bridgewire/hodor_picontroller/docs/hardware_discrete/schematic_notes.md

# Schematic notes

T1 (power supply) Screw terminal connectors Left to Right:

| L | N | GND | V2 | COM | V1 |
| --- | --- | --- | --- | --- | --- |
|  |  |  |  |  |  |  |

Signal Descriptions:

| Name | Description |
| --- | --- |
| L | Mains input live (black or red) |
| N | Mains input neutral (white) |
| GND | Mains input frame ground (green) |
| V2 | 12V supply output |
| COM | supply output common ground |
| V1 | 5V supply output |

MCU1 (Raspberry Pi) GPIO pin usage:

| Pin Number | Description |
| --- | --- |
|  2  | +5V (suggest use along with 4) |
|  4  | +5V (suggest use along with 2) |
|  6  | GND |
| 8-14 | (unused) |
| 16 | GPIO16 - assert high when authorized user scans card |

**NOTE** Pins 2,4 required for direct wire connection to power supply T1.  Pins 2,4 may be left unused if one supplies power to the Raspberry Pi via the micro-USB port.

MCU2 (Arduino) connection points:

| Pin ID | Description |
| --- | --- |
| VIN | Power supply in (regulated 5V) |
| GND | Ground |
| D13 | integrated LED |
| D5  | unlock pin (assert high) |
| D4  | accept pin (assert high) from RPi |
| D3  | door switch input |
| D2  | door LED enable (assert high) |
**NOTE** : The VIN pin required for connection to power supply T1.  The VIN pin may be unused if Arduino is powered by USB or barrel connector

RLY1 (Beefcake Relay Control Kit) connection points:

Low-voltage (smaller, black) terminal block:

| Pin Name | Description |
| --- | --- |
| 5V | Power input (5V) |
| CTRL | relay control signal |
| GND | Ground |

High-voltage (larger, blue) connection points:

| Pin Name | Description |
| --- | --- |
| NC | Relay Normally Closed contact |
| NO | Relay Normally Open contact |
| COM | Relay common contact |

5V rail connections (T1:V1):
* `RLY1:5V`
* `MCU2:VIN`
* `MCU1:+5v(2,4)`
* `T1:V1`

12V rail connections (T1:V2):
* `T1:V2`
* `RLY1:COM`

Ground connections (T1:GND):
* `T1:GND`
* `RLY1:GND`
* `MCU1:GND`
* `MCU2:GND`
* `L1`
* `L2`
* `BTN1`
+ `BTN1LED:-`

Point-to-Point connections:
* `PCB1:USB   <=> MCU1:USB (USB Cable)`
* `MCU2:D3`    => `BTN1LED:+`
* `RLY1:NO     => L1`
* `RLY1:NC     => L2`
* `RLY1:CTRL   => MCU2:D5`
* `MCU2:D2     => BTN1SW:+`
* `BTN1        => MCU2:D3`
* `MCU1:GPIO16 => MCU2:D4`
