bridgewire/hodor_picontroller/docs/hardware_discrete/figures/discrete_arduino_test_ckt_202004302058.pdf

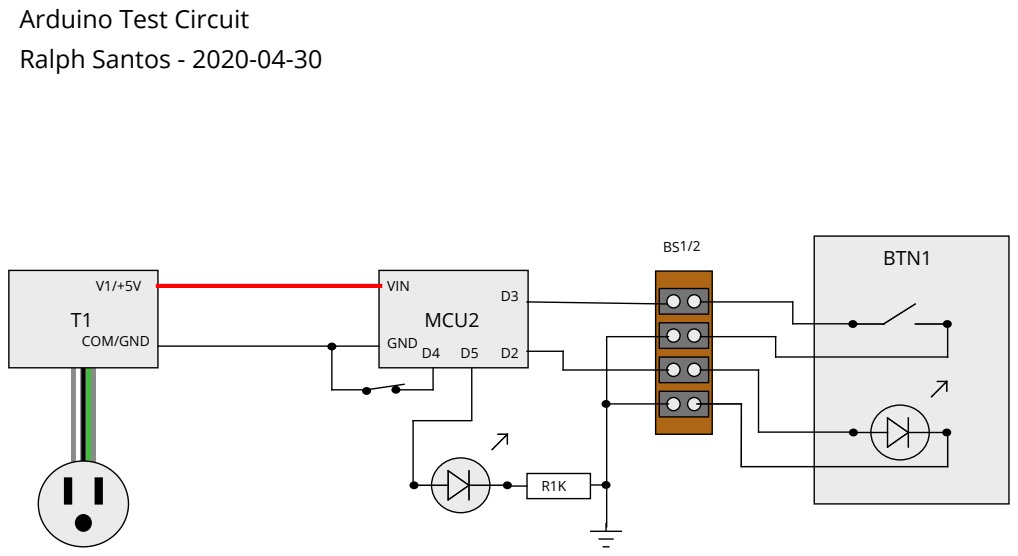
[picture p1: page 1]
BTN1; MCU2; COM/GND; GND; VIN

Arduino Test Circuit
Ralph Santos - 2020-04-30
