bridgewire/hodor_picontroller/docs/hardware_discrete/figures/discrete_hardware_202004302058.pdf

## RLY1

## L1/STRIKE

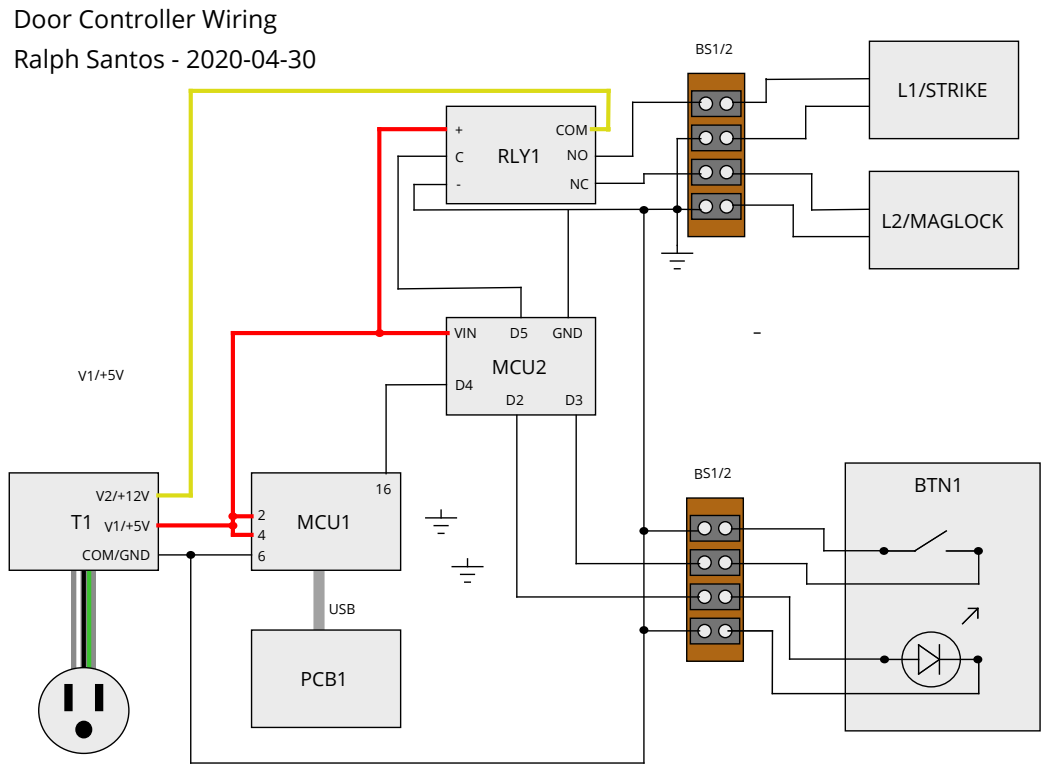
[picture p2: page 1]
BTN1; MCU2; MCU1; PCB1; L2/MAGLOCK; COM; COM/GND; USB; GND; VIN

Door Controller Wiring
Ralph Santos - 2020-04-30
