bridgewire/hodor_picontroller/(commit log)

2017-05-06 log dir init fix
    [watcher.py]
2017-05-06 fix to rootdir config
    [watcher.py]
2018-02-24 playbook adjustments
    [hodor_controller_playbook.yml]
2018-02-24 paybook unify and extend
    [hodor_controller_playbook.yml]
2018-02-27 add drop of example bw_cardkey.csv to playbook
    [example_bw_cardkey.csv]
2020-04-19 pass device name as CLI option
2020-04-20 start docs for discrete hardware assembly
2020-04-20 BOM and schematic notes updates
2020-04-20 BOM update
2020-04-20 assembly notes - add testing details
2020-04-20 update hw assembly notes
2020-04-20 commit Arduino sketches
2020-04-22 fix log and byte object scan errors
    [watcher.py]
2020-04-22 hodor_slacker - stall gracefully if no config
2020-04-22 BOM and schematic updates
2020-04-23 BOM updates
2020-04-27 add schematic figures
2020-05-01 update figures - drop PCB2
2020-05-03 remove PCB2 from docs
2020-05-10 finish assembly instructions
2020-06-07 schematic notes update
2021-08-27 add info about new Raspberry Pi setup
